abdullxhsalim/barebones/pictures/20241207_221119.jpg

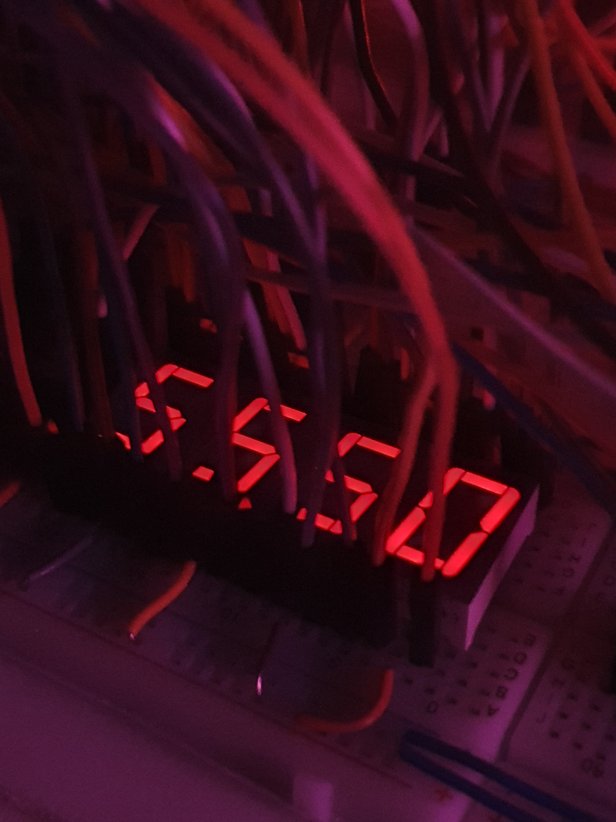
pictures/20241207_221119.jpg
