abdullxhsalim/barebones/pictures/20241207_221142.jpg

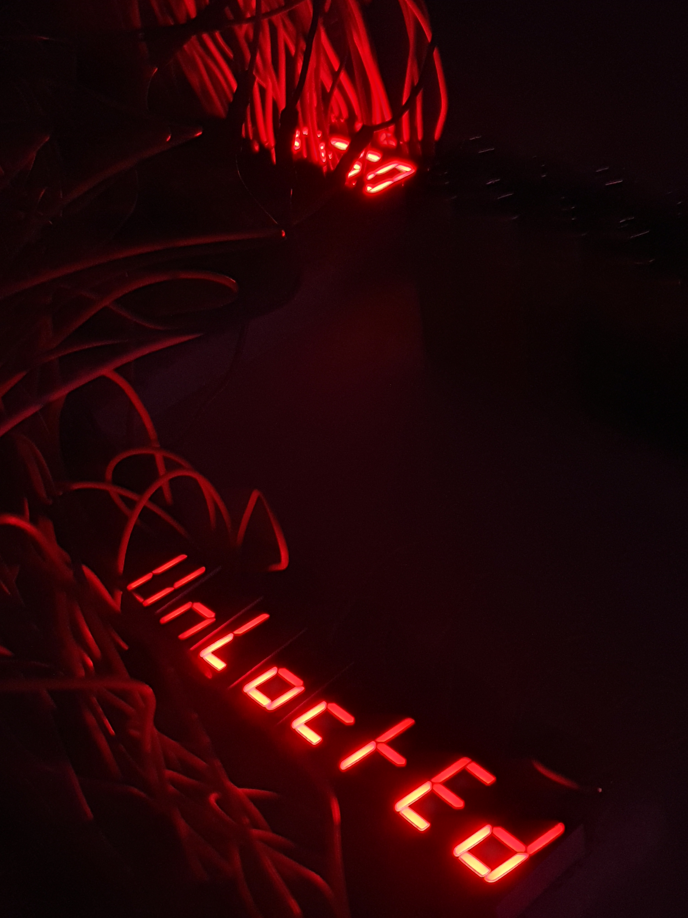
pictures/20241207_221142.jpg
