abdullxhsalim/barebones/pictures/20241207_221308.jpg

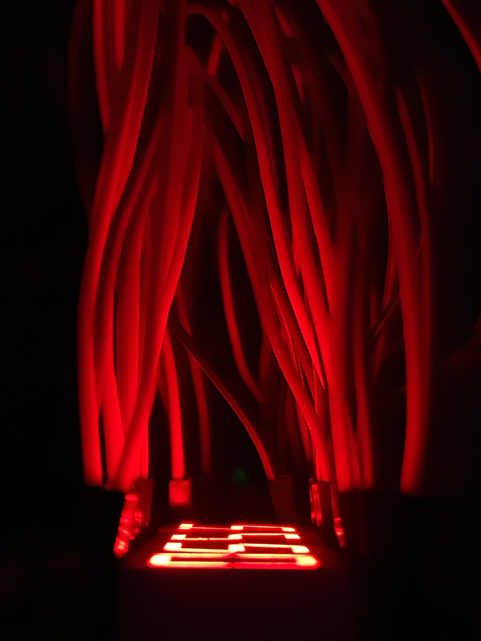
pictures/20241207_221308.jpg
