abdullxhsalim/barebones/pictures/20241207_221452.jpg

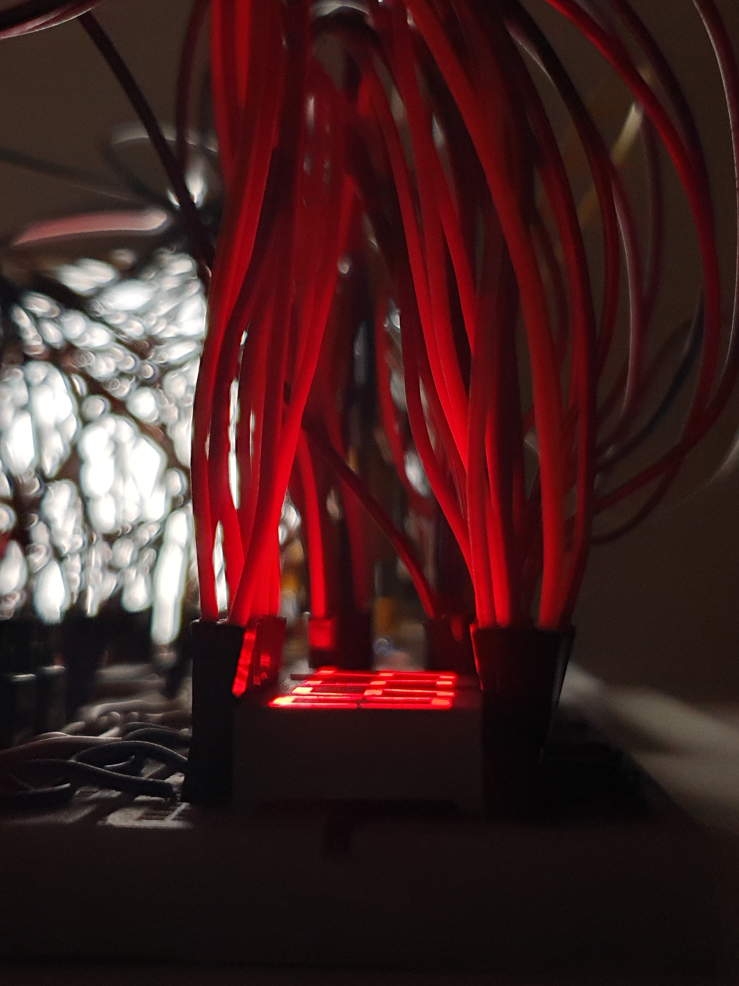
pictures/20241207_221452.jpg
