abdullxhsalim/barebones/pictures/20241207_221627.jpg

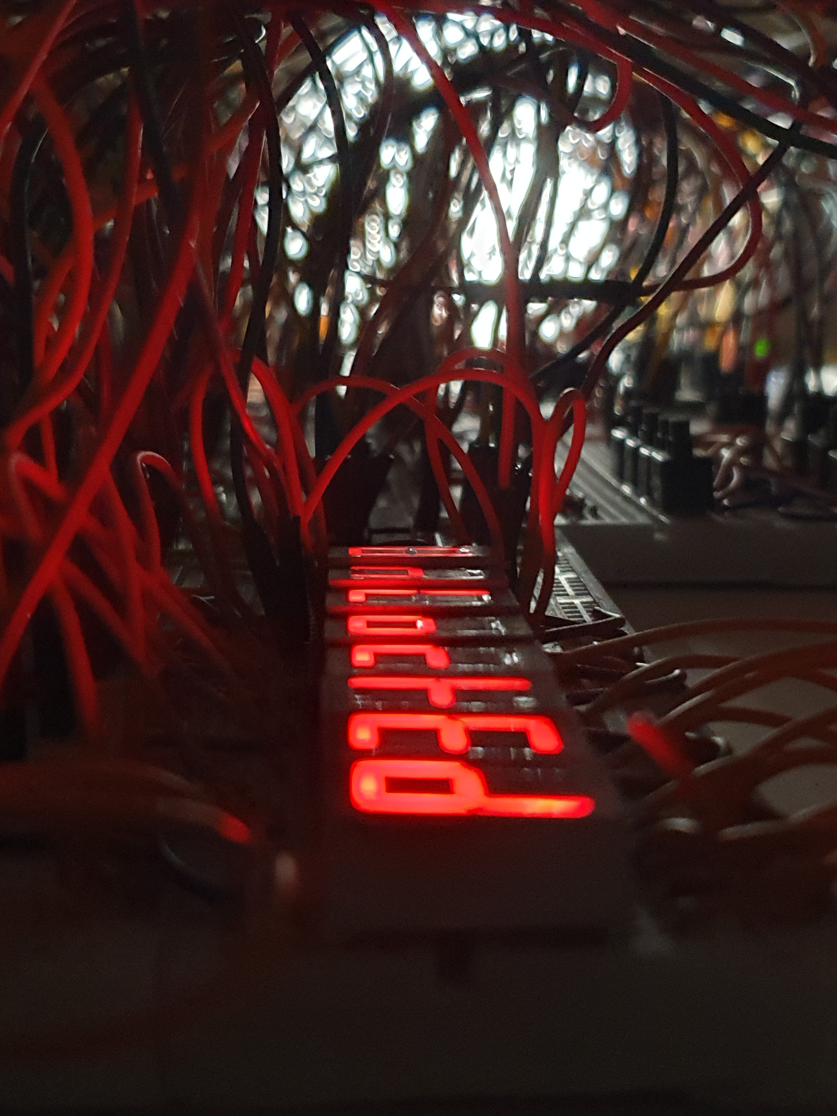
pictures/20241207_221627.jpg
