abdullxhsalim/barebones/(list of files, drawings)

Other design files:
simulation/Simulation.circ
