abdullxhsalim/barebones/(commit log)

2025-01-18 Added files required for simulation
    [Simulation Simplified.circ]
2025-04-28 Added top-down view picture of the circuit
