abdullxhsalim/barebones/pictures/20241204_115236.jpg

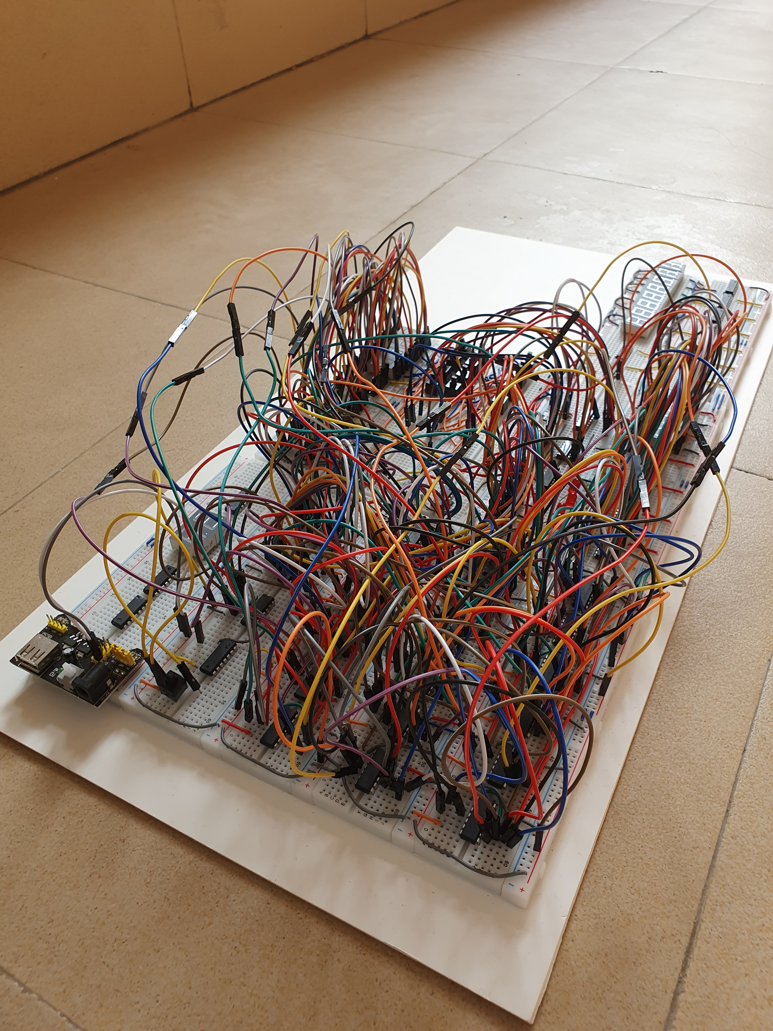
[picture p3: pictures/20241204_115236.jpg]
pictures/20241204_115236.jpg
